arthur-jacquin/tipe/readme.md

# Un détecteur d'obstacles pour malvoyants

Projet réalisé lors du TIPE.

- Présentation du projet : `tipe.html`
- Rapport : `rapport.pdf`
- Support de présentation : `tipe.pdf`

<p align="center">
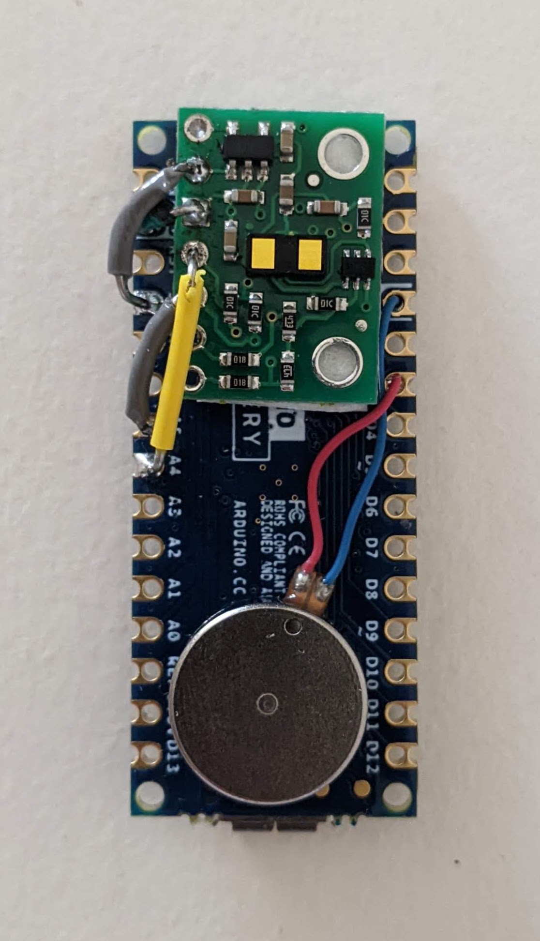
[picture p1: images/produit_fini.jpg]
  
</p>
