arthur-jacquin/tipe/notes.md

# Savoir parler de

% Protocole de tests
% Arduino pinout scheme
% Fonctionnement des composants
% Interface I2C
% Processus de soudure, règles de sécurité
% Liste des problèmes
    % Souder - déssouder les composants non brochés
    % Pbms de driver, port de communication
        Problème rencontré : Serial port not selected. (2 heures de recherche)
        1. Le microcontrolleur n'est pas reconnu. Installation du driver (problèmes de drivers non signés).
        2. Il n'est pas possible de sélectionner un port. Installation d'un second driver. 
    % Autres microcontrôleurs, plus compact mais tension insuffisante
    % Téléchargement manuel de certains paquets (e.g. logreq) dans le dossier de travail
% Breadboard = plaque de montage
% Fil de soudure : 99.3% d'étain, 0.7% de cuivre
% Interface I²C (Inter-integrated circuit, meaning serial bus)
% VL53L1X : 16x16 Single Photon Avalanche Diode
%           Integrated lens

# Ressources

https://www.precisionmicrodrives.com/ab-028
https://www.pololu.com/product/3415
https://www.pololu.com/file/0J1506/vl53l1x.pdf
https://www.maxbotix.com/documents/HRLV-MaxSonar-EZ_Datasheet.pdf
