arthur-jacquin/tipe/images/schema_soudure.jpg

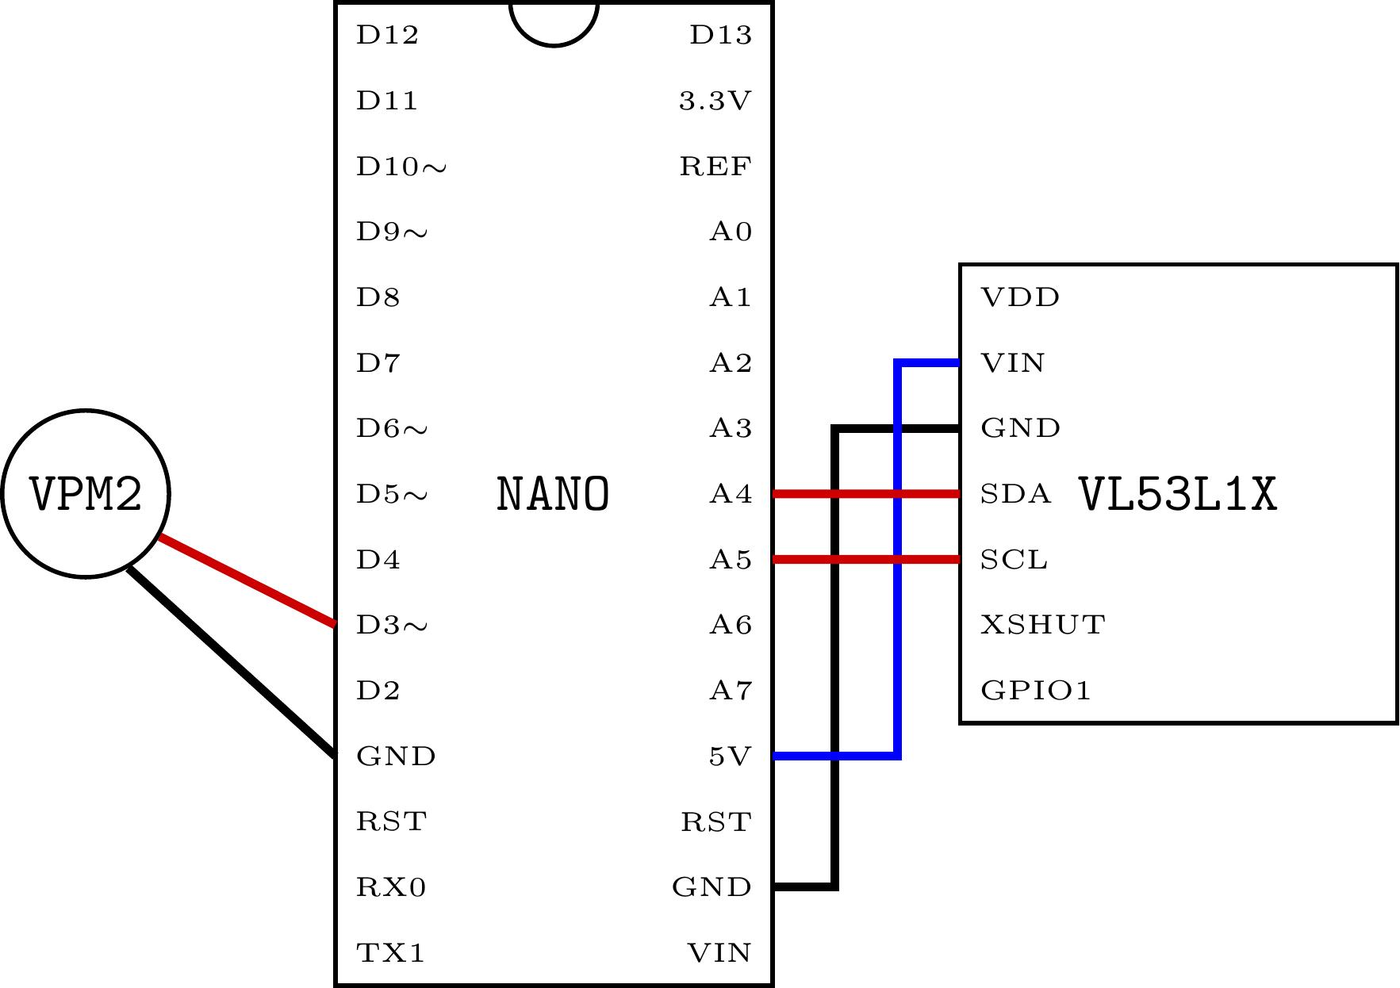
images/schema_soudure.jpg
