arthur-jacquin/tipe/(commit log)

2022-06-06 Ajout des fichiers
2022-06-06 Ajout du dossier des images
2022-06-06 Ajout des images
2022-06-06 Ajout de la page de présentation
2022-06-06 Ajout du schéma de soudure
2022-06-13 Ajout du rapport pour les ENS
2022-06-13 Mise à jour des liens
2022-06-13 Ajout de la bibliographie
2022-06-13 Ajout des notes
